CristeaDP/Voltage-stabilizer-with-series-regulator/Layout/layout.jpg

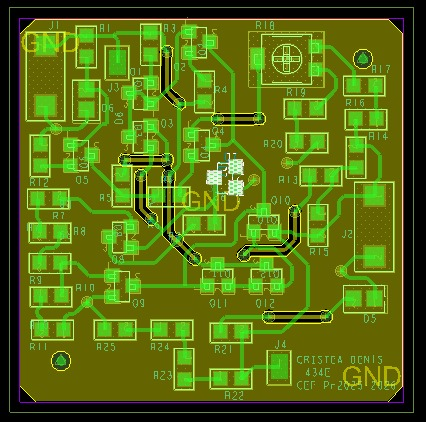
Layout/layout.jpg
