CristeaDP/Voltage-stabilizer-with-series-regulator/README.md

```
STABILIZATOR DE TENSIUNE CU ELEMENT DE REGLAJ SERIE (3–6 V)

DESCRIERE
Acest proiect prezintă proiectarea și analiza unui stabilizator de tensiune
liniar cu element de reglaj serie (ERS), capabil să furnizeze o tensiune
stabilizată reglabilă în intervalul 3 V – 6 V.

Scopul stabilizatorului este de a menține o tensiune de ieșire constantă
chiar și atunci când:
- tensiunea de intrare variază
- sarcina conectată la ieșire se modifică

Reglarea tensiunii se realizează prin intermediul unui tranzistor utilizat
ca element de reglaj serie, care controlează căderea de tensiune dintre
intrare și ieșire.

PRINCIPIUL DE FUNCȚIONARE
Stabilizatorul funcționează pe baza controlului curentului care trece
de la sursa de alimentare către sarcină.

Blocurile principale ale circuitului sunt:

1. Sursa de tensiune de intrare
   Furnizează tensiunea brută ce trebuie stabilizată.

2. Referința de tensiune
   Generează o tensiune stabilă utilizată pentru reglaj.

3. Amplificatorul de eroare
   Compară tensiunea de ieșire cu tensiunea de referință.

4. Elementul de reglaj serie (tranzistor)
   Controlează căderea de tensiune pentru menținerea
   unei tensiuni constante la ieșire.

5. Sarcina
   Circuitul alimentat de stabilizator.

CARACTERISTICI PRINCIPALE
- Tip stabilizator: liniar cu element de reglaj serie
- Tensiune de ieșire reglabilă: 3 V – 6 V
- Stabilizare la variații ale tensiunii de intrare
- Stabilizare la variații ale sarcinii
- Proiect verificat prin simulări

STRUCTURA PROIECTULUI

Bill_of_Materials
Lista componentelor utilizate în circuit

Data_Sheets
Fișele tehnice ale componentelor electronice

Layout
Fișierele pentru layout-ul plăcii PCB

Project docs
Documentația proiectului

Schematics / FAZA_1
Schema electrică a stabilizatorului

Simulations
Fișierele și rezultatele simulărilor circuitului

FIȘIERE SUPLIMENTARE
Schema_bloc.jpg
Diagrama bloc a sistemului

PCB_Manufacturing_Table.docx
Parametrii necesari pentru fabricarea PCB-ului

Prezentarea_Cristea_Denis_434E.pptx
Prezentarea proiectului

Tema 3 - Stabilizator de tensiune cu ERS.pdf
Cerințele și descrierea temei

APLICAȚII
Stabilizatoarele de tensiune de acest tip sunt utilizate în:
- alimentarea circuitelor electronice de mică putere
- sisteme embedded
- circuite analogice sensibile la variații de tensiune
- aplicații educaționale în electronică

AUTOR
Denis Cristea
Proiect realizat în cadrul laboratorului de Electronică.
```
