CristeaDP/Voltage-stabilizer-with-series-regulator/Schematics/FAZA_1/Lib_ModelePSpice_Anexa_1/Lib_ModelePSpice_Anexa_1/A1-active lib.docx

77 | 4148 | (LINK) (http://www.tme.eu/ro/details/1n4148-0805/diode-universale-smd/dc-components/cd4148ws0805c/) | 1N4148-0805
79 | 2.7V | (LINK) (http://www.tme.eu/ro/details/bzx84c2v7/diode-zener-smd/on-semiconductor/bzx84c2v7lt1g/) | BZX84C2V7
80 | 5.1V | (LINK) (http://www.tme.eu/ro/details/bzx84c5v1/diode-zener-smd/nxp/bzx84-c5v1215/) | BZX84C5V1
81 | 5.6V | (LINK) (http://www.tme.eu/ro/details/bzx84c5v6/diode-zener-smd/nxp/bzx84-c5v6215/) | BZX84C5V6
82 | 6.2V | (LINK) (http://www.tme.eu/ro/details/bzx84c6v2/diode-zener-smd/nxp/bzx84-c6v2215/) | BZX84C6V2
83 | 6.8V | (LINK) (http://www.tme.eu/ro/details/bzx84c6v8/diode-zener-smd/nxp/bzx84-c6v8215/) | BZX84C6V8
84 | 8.2V | (LINK) (http://www.tme.eu/ro/details/bzx84c8v2/diode-zener-smd/nxp/bzx84-c8v2215/) | BZX84C8V2
85 | 10V | (LINK) (http://www.tme.eu/ro/details/bzx84c10/diode-zener-smd/nxp/bzx84-c10215/) | BZX84C10
86 | PNP | (LINK) (http://www.tme.eu/ro/details/bc856b.215/tranzistori-smd-pnp/nxp/) | BC856B
87 | NPN | (LINK) (http://www.tme.eu/ro/details/bc846b.215/tranzistori-smd-npn/nxp/) | BC846B
89 | N-JFET | (LINK) (http://www.tme.eu/ro/details/mmbfj309lt1g/tranzistori-canal-n-smd/on-semiconductor/) | MMBFJ309LT1G
90 | P-JFET | (LINK) (http://www.tme.eu/ro/details/mmbfj177lt1g/tranzistori-canal-p-smd/on-semiconductor/) | MMBFJ177LT1G
91 | NPN | (LINK) (http://www.tme.eu/ro/details/bc817-25-dio/tranzistori-smd-npn/diotec-semiconductor/bc817-25/) | BC817-25-DIO
93 | PNP | (LINK) (http://www.tme.eu/ro/details/bc807-25-dio/tranzistori-smd-pnp/diotec-semiconductor/bc807-25/) | BC807-25-DIO
94 | NPN | (LINK) (http://www.tme.eu/ro/details/mjd31cg/tranzistori-smd-npn/on-semiconductor/) | MJD31CG
96 | PNP | (LINK) (http://www.tme.eu/ro/details/mjd32cg/tranzistori-smd-pnp/on-semiconductor/) | MJD32CG
97 | Nmos | (LINK) (http://www.tme.eu/ro/details/irfr120npbf/tranzistori-canal-n-smd/international-rectifier/) | IRFR120NPBF
