CristeaDP/Voltage-stabilizer-with-series-regulator/Proiect docs/Proiect_1_Cristea_Denis.pdf

Universitatea Națională de Știință și Tehnologie POLITEHNICA București Facultatea de Electronică, Telecomunicații și Tehnologia Informației

# Circuite Electronice Fundamentale 2 – Proiect

Stabilizator de tensiune cu element de reglaj serie (ERS)

Student: CRISTEA Denis-Petrișor | Profesori coordonatori: Dr.Ing Florin Draghici
Grupă: 434E | S.I.dr.Ing Mihaela Pantazica

An universitar 2025-2026

# Cuprins

### 1. Date inițiale de proiectare

### 2. Conținut tehnic/științific al proiectului

### 3. Simulări efectuate pentru a demonstra funcționalitatea în

parametrii impuși

### 1. Date inițiale de proiectare

### 1.1. Tema proiectului

Să se proiecteze și realizeze un stabilizator de tensiune cu ERS având următoarele caracteristici pentru N = 6:

- Tensiunea de ieșire reglabilă în intervalul: 3 – 6 [V];
- Element de reglaj serie;
- Sarcină la ieșire: 240 [Ω];
- Deriva termică: < 2mV/°C;
- Protecție la suprasarcină prin limitarea temperaturii tranzistorului regulator serie la 120 °C și a curentului maxim la 0,5A;
- Tensiune de intrare în intervalul: 10.8 – 12 [V]
- Domeniul temperaturilor de funcționare: 0 ° -60 °C (verificabil prin testare în temperatură);
- Amplificarea în tensiune minimă (în buclă deschisă) a amplificatorului de eroare: minim 100;
- Semnalizarea prezenței tensiunilor de intrare/ieșire cu diodă de tip LED.

### 1.2. Schema bloc a montajului electric

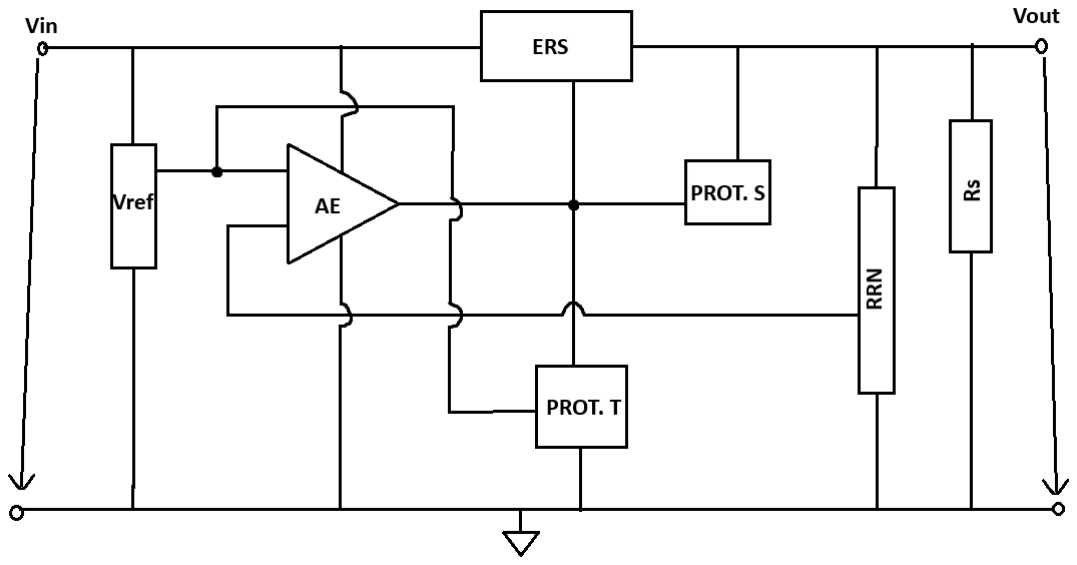
[picture p9: figure]

LEGENDA:
- V REF - referința de tensiune
- AE - amplificator operațional de eroare
- ERS - element de reglaj serie ( grupare Darlington)
- PROTECȚIE S. - circuit de protecție la suprasarcină
- PROTECȚIE T. - circuit de protecție la temperature
- RRN - rețea de reacție negative
- RS - sarcina la ieșire

### 1.3. Schema electrică a montajului electric

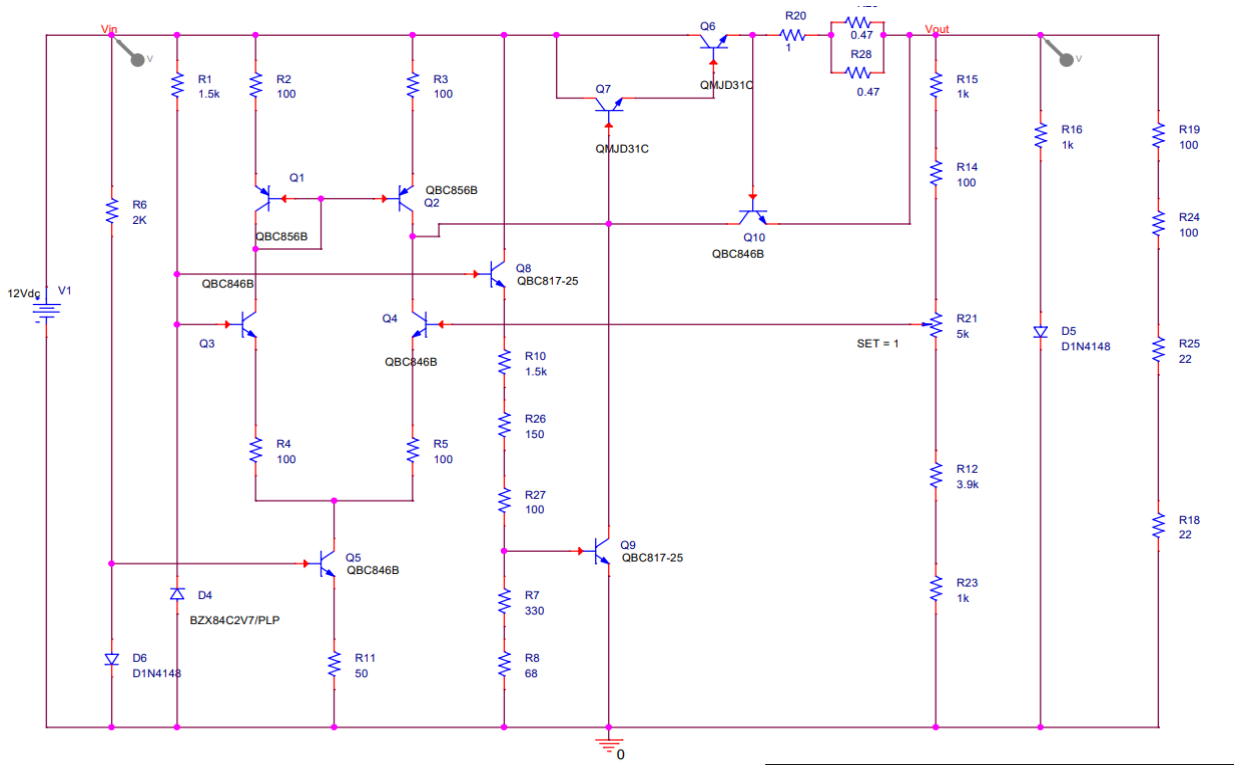
[picture p10: figure]

Compunerea circuitului din următoarele blocuri:
- Referința de tensiune : DZ
- Amplificator operațional de eroare: tranzistoarele Q3, Q4, oglinda de curent Q1, Q2, R2, R3 și generatorul de curent Q5, R11
- Element de reglaj serie (ERS): Q6, Q7 ( în configurație Darlington )
- Protecția la suprasarcină: Q10, R20
- Protecția termică: Q8, Q9, R10, R26, R27, R7, R8
- Rețeaua de reacție negativă: R15, R14, R12, R21, R23
- Impedanța de sarcină: R19, R24, R25, R18
- Semnalizare LED-uri: Intrare: D6, R6 ; Ieșire: D5, R16

### 2. Conținut tehnic/științific al proiectului

### 2.1. Descrierea funcționării schemei de proiectare

Stabilizatorul de tensiune este circuitul cu rol în asigurarea la ieșire a unei tensiuni constante în condițiile în care tensiunea de la intrare, curentul și temperatura variază.

### 2.1.1. Referința de tensiune

Această parte a circuitului utilizează o diodă Zener pentru a stabiliza tensiunea de intrare, fără a ține cont de diverși parametrii precum: sarcina, variațiile tensiunii de alimentare sau chiar ale temperaturii.
Circuitul implică utilizarea unei diode de tip BZX84-C2V7, care are o tensiune de străpungere constantă de aproximativ 2.7V la un curent de 6mA. Dioda Zener va funcționa în regim de străpungere, iar un aspect important este asigurarea unui curent prin aceasta mai mare decât Izmin (curentul minim necesar pentru a menține dioda în regim de străpungere).

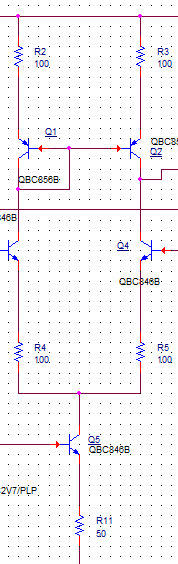
[picture p11: figure]

### 2.1.2. Amplificatorul de eroare

În acest circuit de amplificare a erorii, tensiunea de ieșire eșantionată este adusă înapoi și comparată cu o tensiune de referință stabilă. Orice diferență între cele două generează o tensiune de eroare de compensare, care acționează pentru a ajusta tensiunea de ieșire pentru a se conforma specificațiilor de proiectare.
Oglinda de curent formată din tranzistoarele Q1, Q2 și rezistențele R2 și R3 are rolul de a oferi o amplificare mult mai bună.

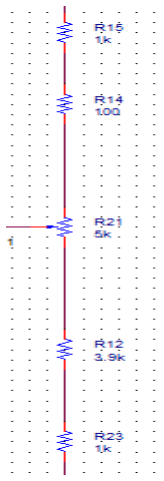
[picture p12: figure]

### 2.1.3. Rețeaua de reacție negativă - RRN

Rețeaua de reacție negativă are rolul de a regla, dar și de a menține tensiunea de ieșire. Aceasta primește o parte din tensiunea de ieșire, pe care o readuce în amplificator prin intrarea inversoare a acestuia.
R21 este un potențiometru (POT) de valoare 5k ce are rolul de a regla tensiunea de la ieșire între 3V și 6V.

### 2.1.4. Elementul de reglaj serie – ERS

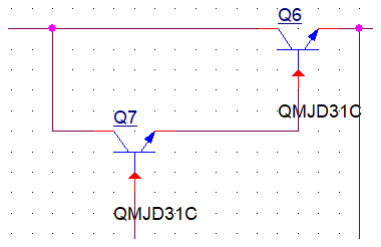
[picture p13: figure]

Elementul de reglaj serie este format din două tranzistoare de putere(de tip MJD31C), aflate într-o configurație de punte Darlington, tranzistoare ce furnizează curent cu un anumit câștig către ieșire.

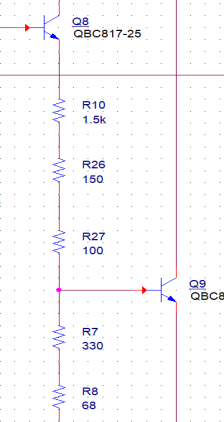
[picture p14: figure]

### 2.1.5. Protecția termică & Protecția la suprasarcină

Protecția termică este alcătuită din două tranzistoare, alături de un divizor rezistiv. Această protecție are rolul de a limita temperatura la 120 °C (temperatură specificată în cerință).

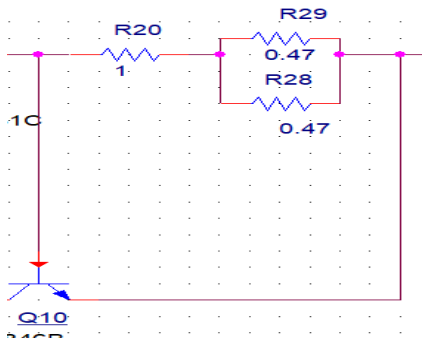
[picture p15: figure]

Protecția la suprasarcină este alcătuită dintr-un tranzistor și o rezistență. Atunci când curentul de pe gruparea de rezistențe ajunge la 0.5A, adică valoarea maximă pe care trebuie să o aibă curentul, tranzistorul nostru se va polariza și va începe să tragă curent din baza tranzistorului de la elementul de reglaj serie.

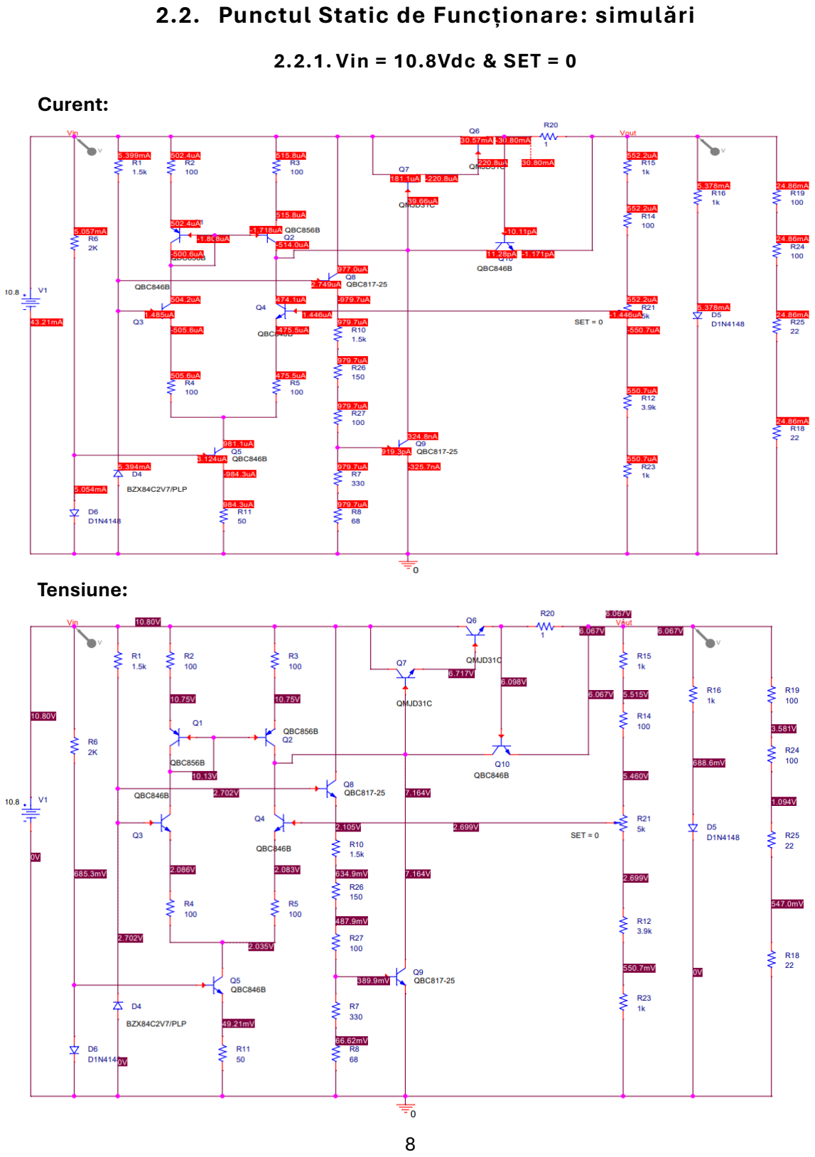
[picture p16: page 8]

### 2.2. Punctul Static de Funcționare: simulări

### 2.2.1. Vin = 10.8Vdc & SET = 0

Curent:

Tensiune:

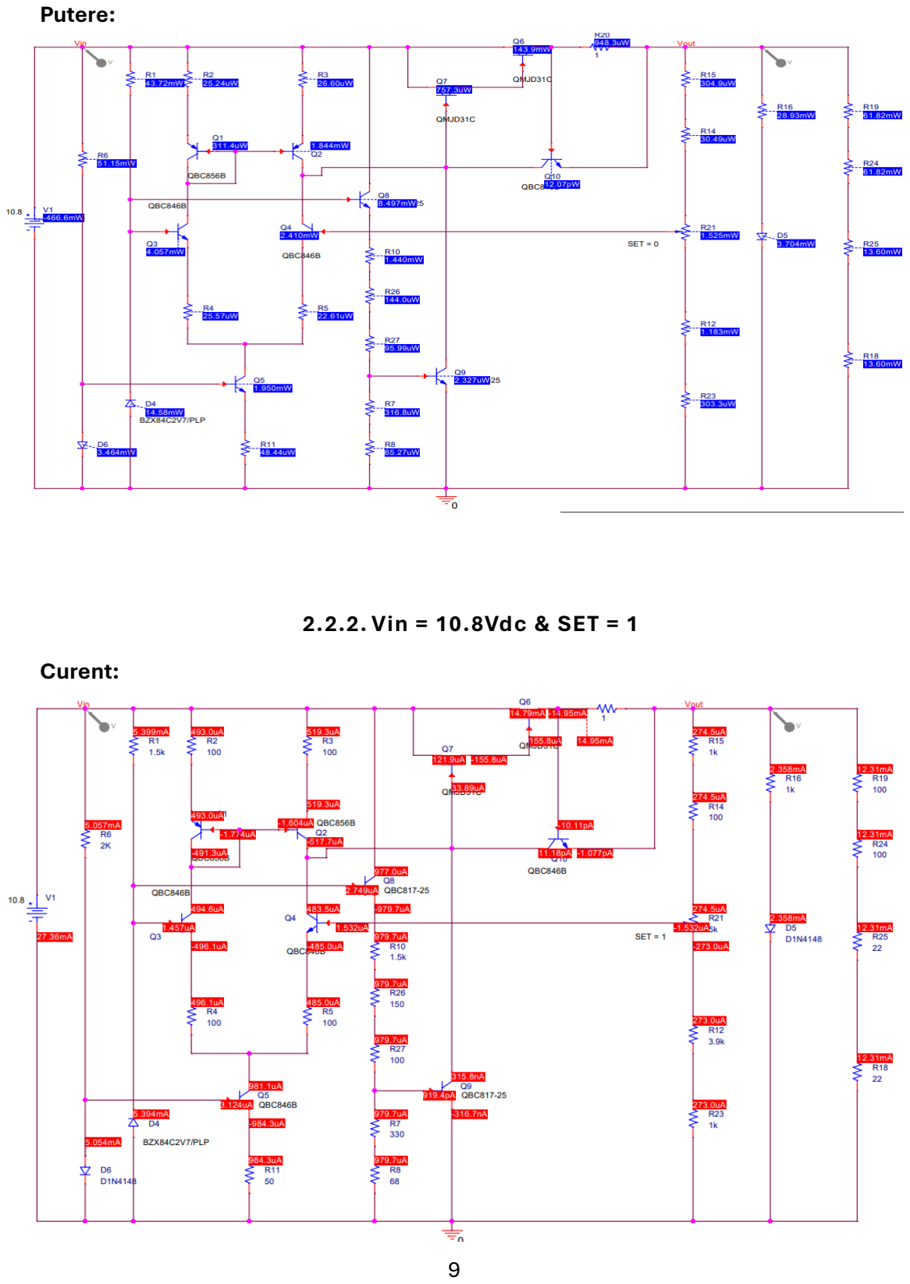
[picture p17: page 9]

Putere:

### 2.2.2. Vin = 10.8Vdc & SET = 1

Curent:

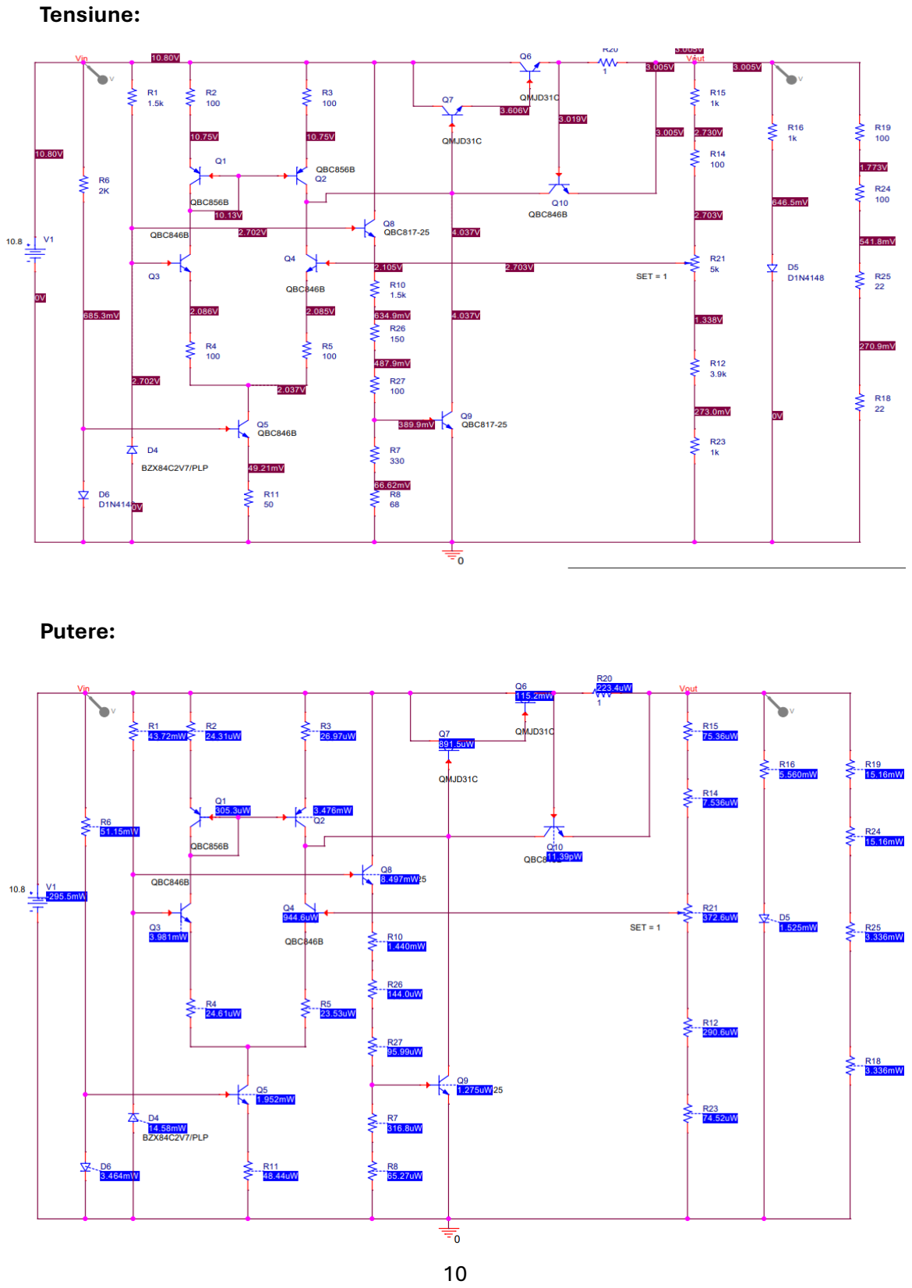
[picture p18: page 10]

Tensiune:

Putere:

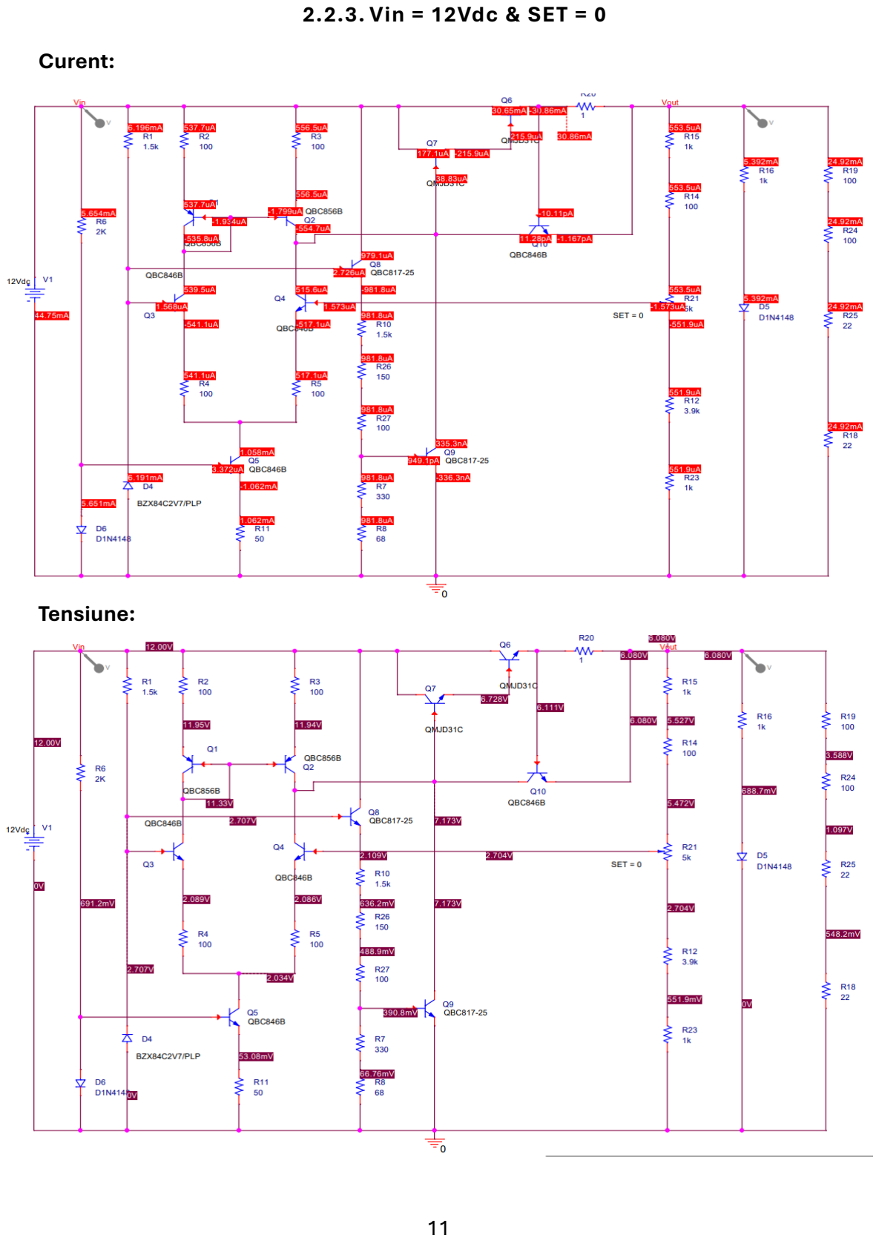
[picture p19: page 11]

### 2.2.3. Vin = 12Vdc & SET = 0

Curent:

Tensiune:

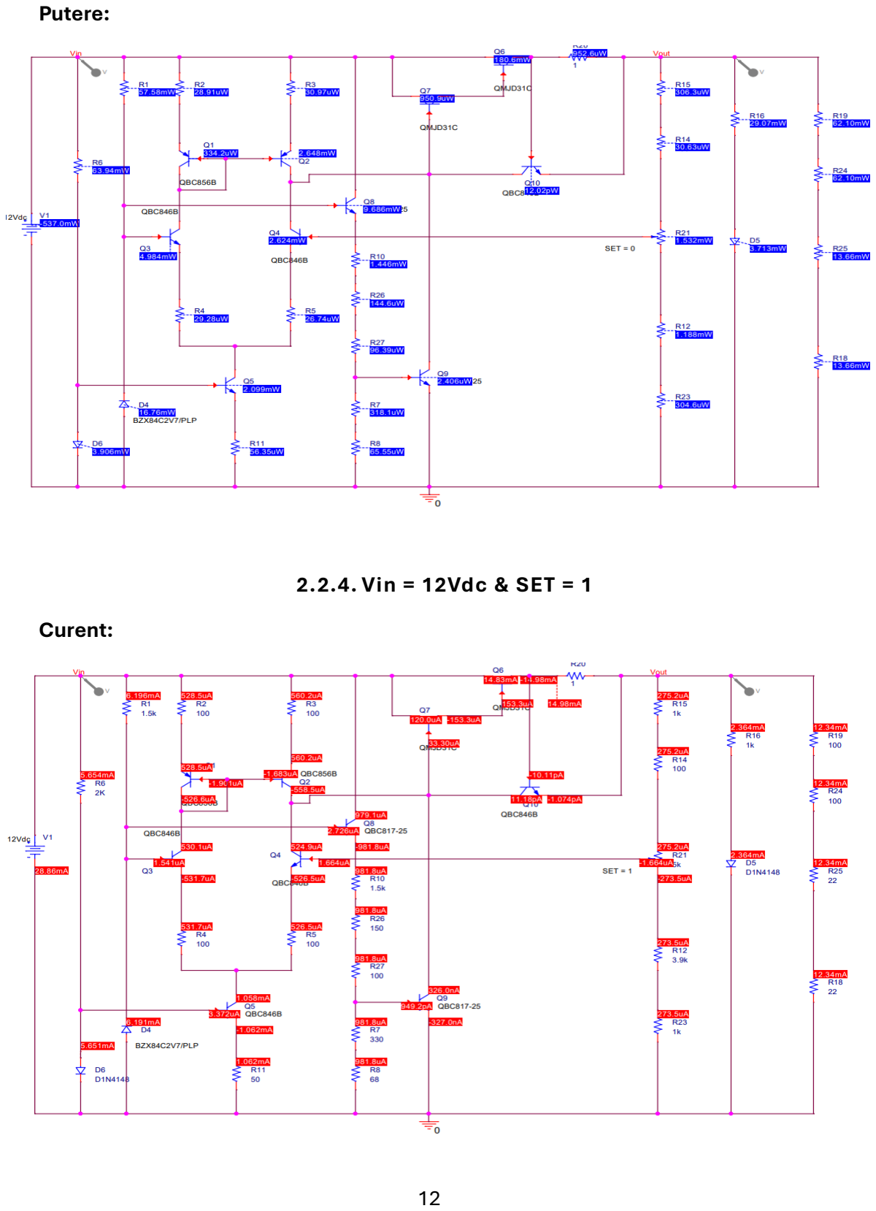
[picture p20: page 12]

Putere:

### 2.2.4. Vin = 12Vdc & SET = 1

Curent:

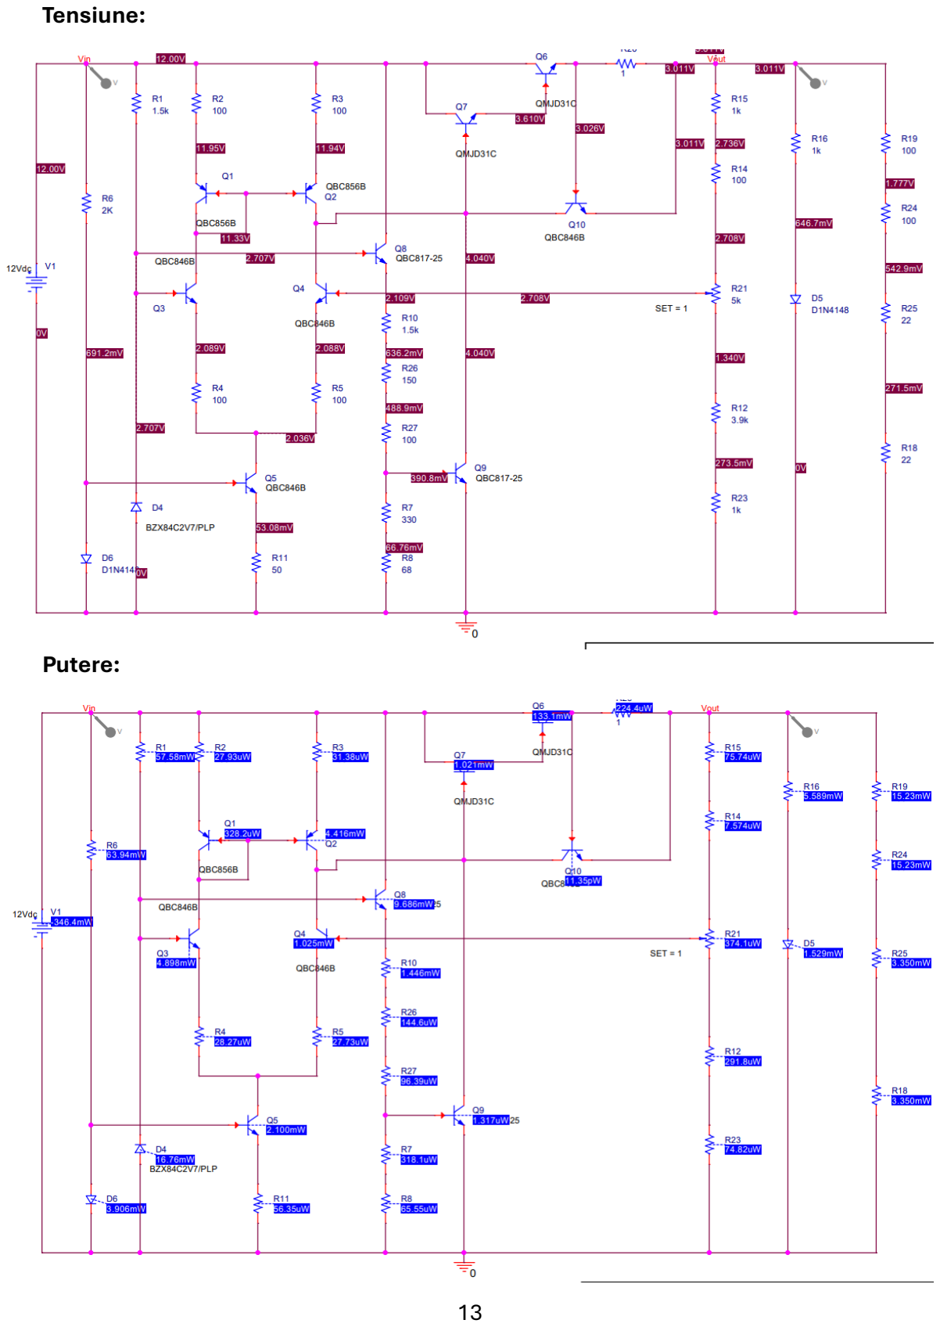
[picture p21: page 13]

Tensiune:

Putere:

### 2.3. Punctul Static de Funcționare: calcul analitic

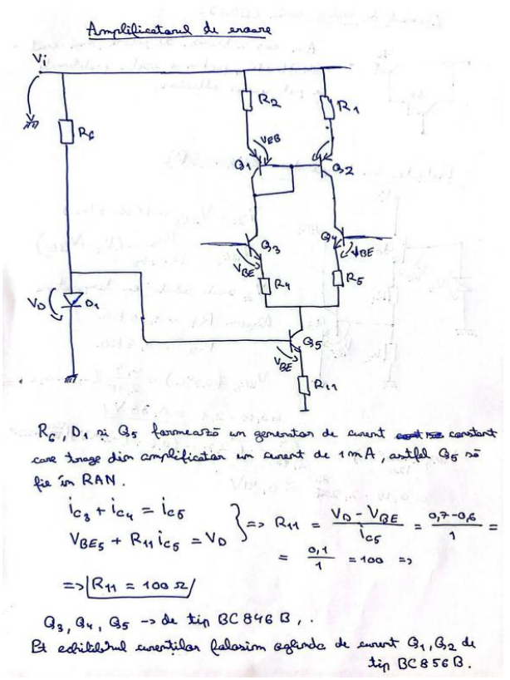
[picture p22: figure]

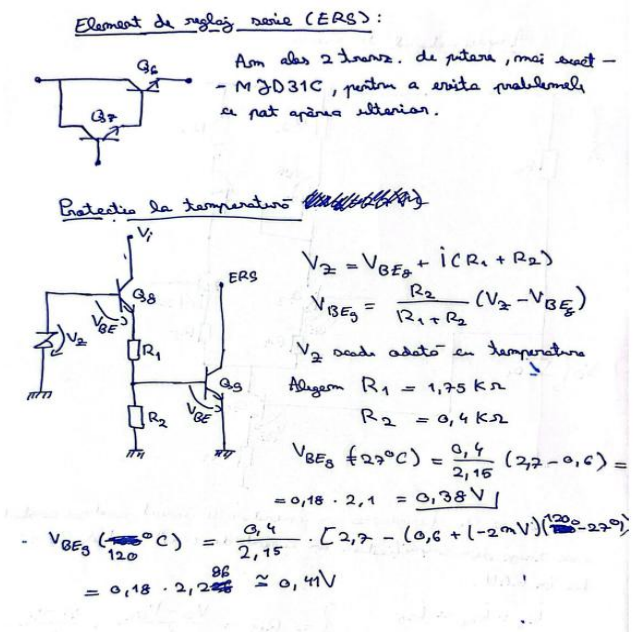
[picture p23: figure]

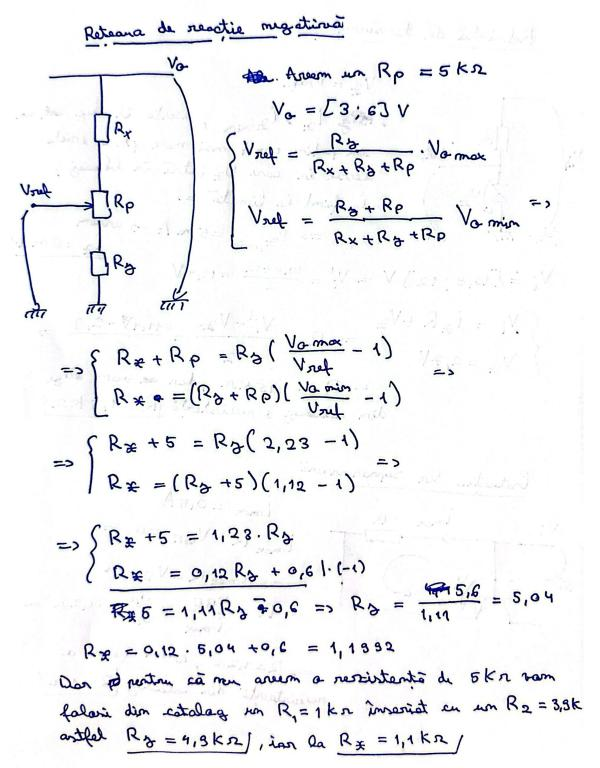
[picture p24: figure]

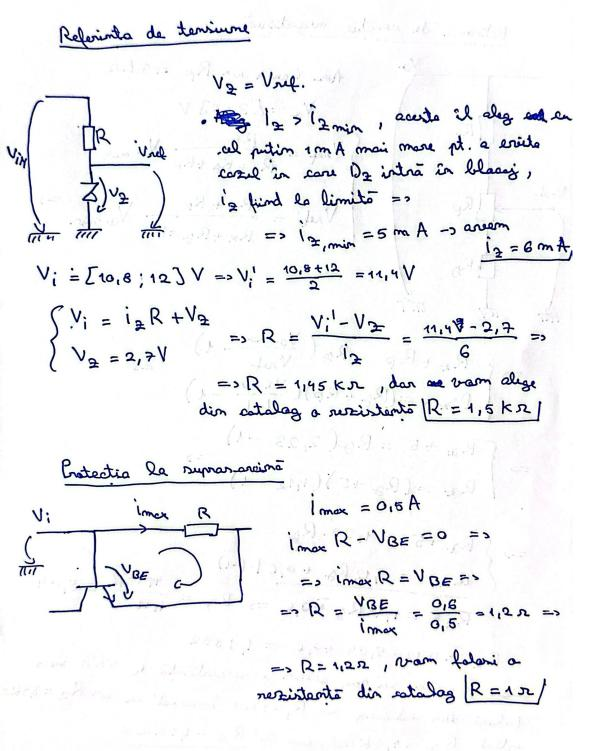
[picture p25: figure]

### 3. Simulări efectuate pentru a demonstra funcționalitatea în

parametrii impuși

### 3.1. Simulare Derivă termică

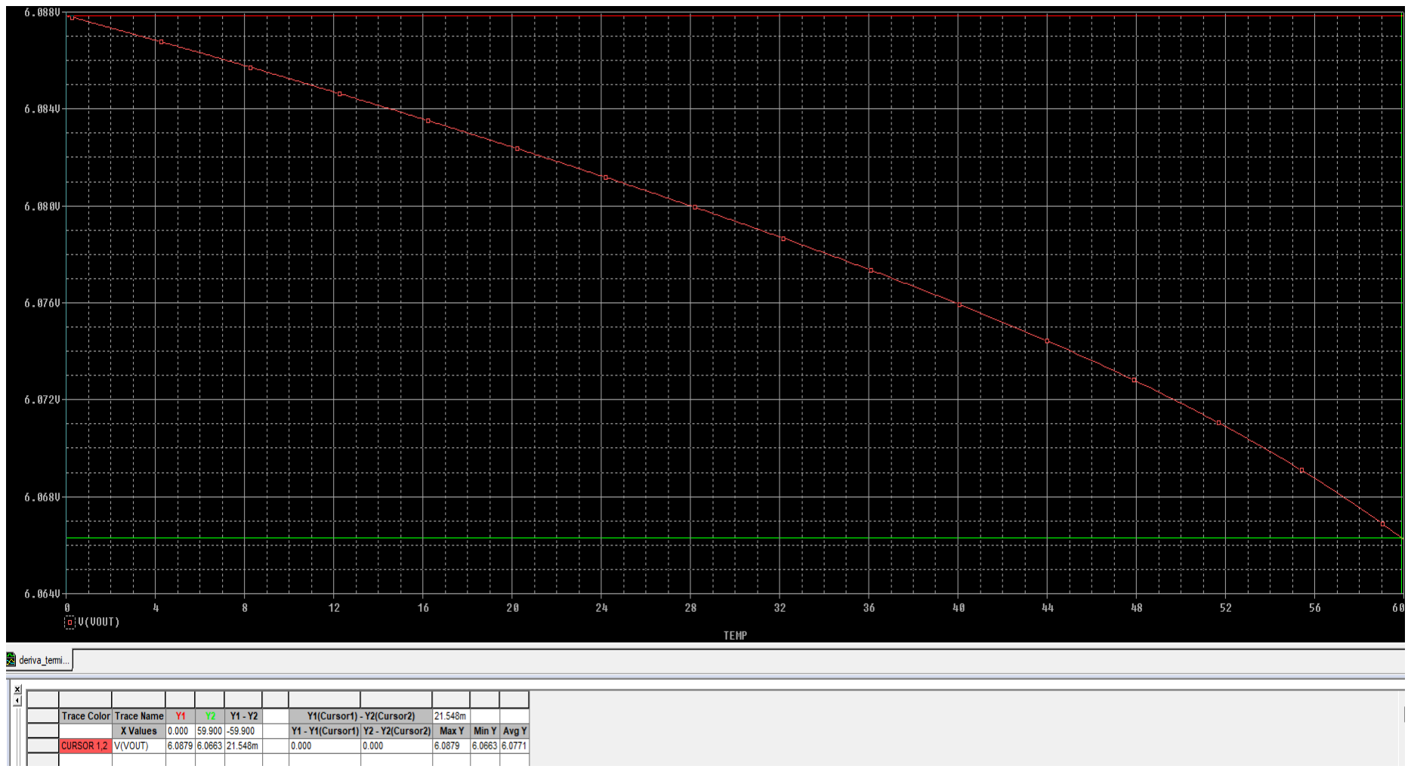
[picture p26: figure]

Deriva termică trebuie să fie < 2mV/°C.

Pentru calcule:
Y1 – Y2 = 21.548mV
t = 60° – 0° = 60°C

Deriva termică =

Y1−Y2
t

=

21.548mV
60°

≅ 0.359mV/°C < 2mV/°C

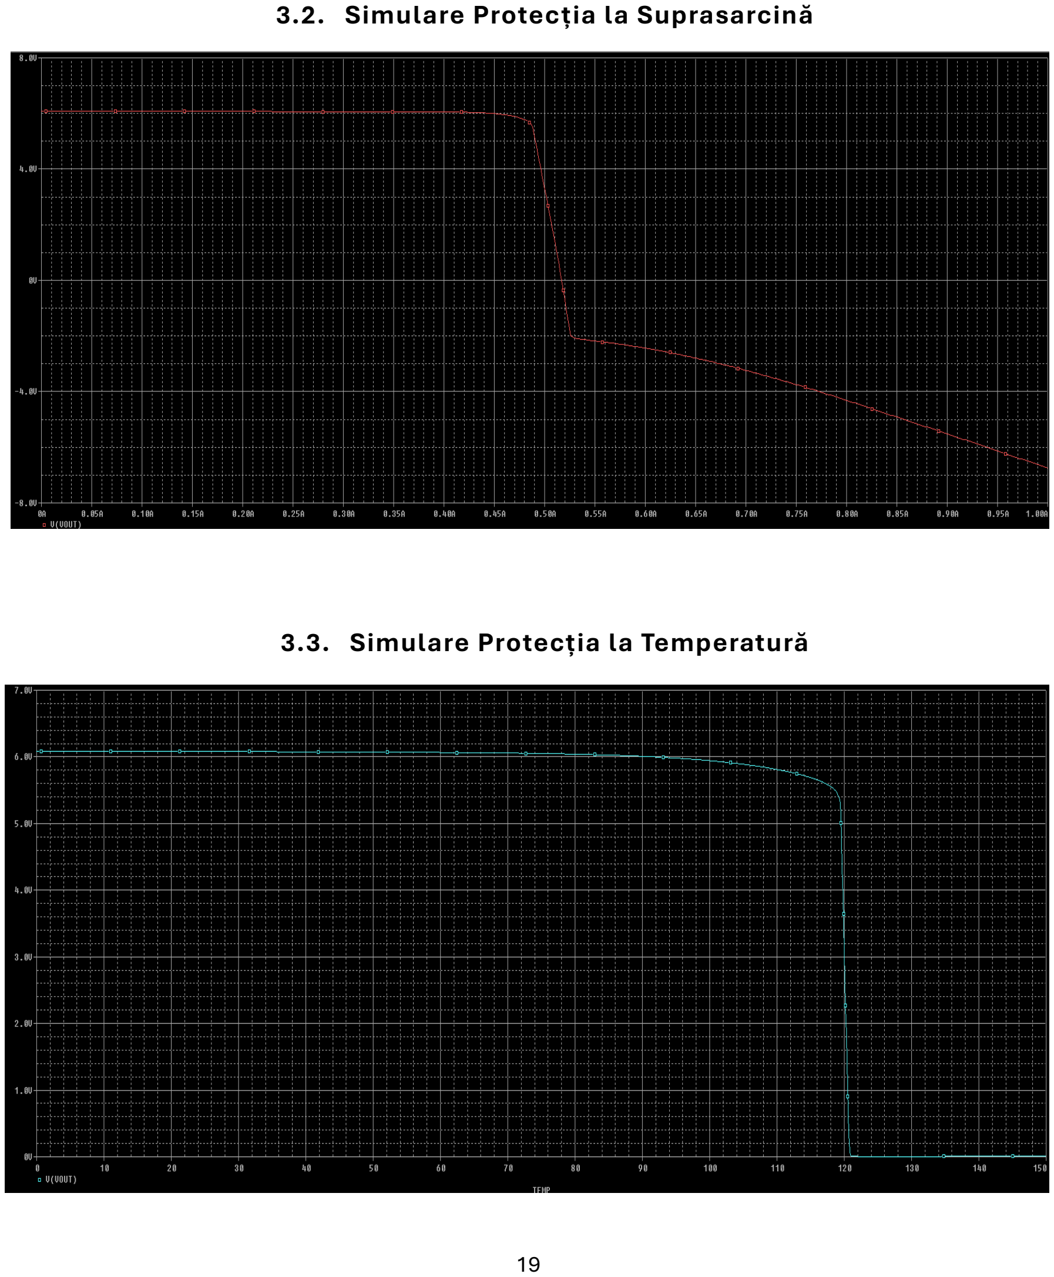
[picture p27: page 19]

### 3.2. Simulare Protecția la Suprasarcină

### 3.3. Simulare Protecția la Temperatură

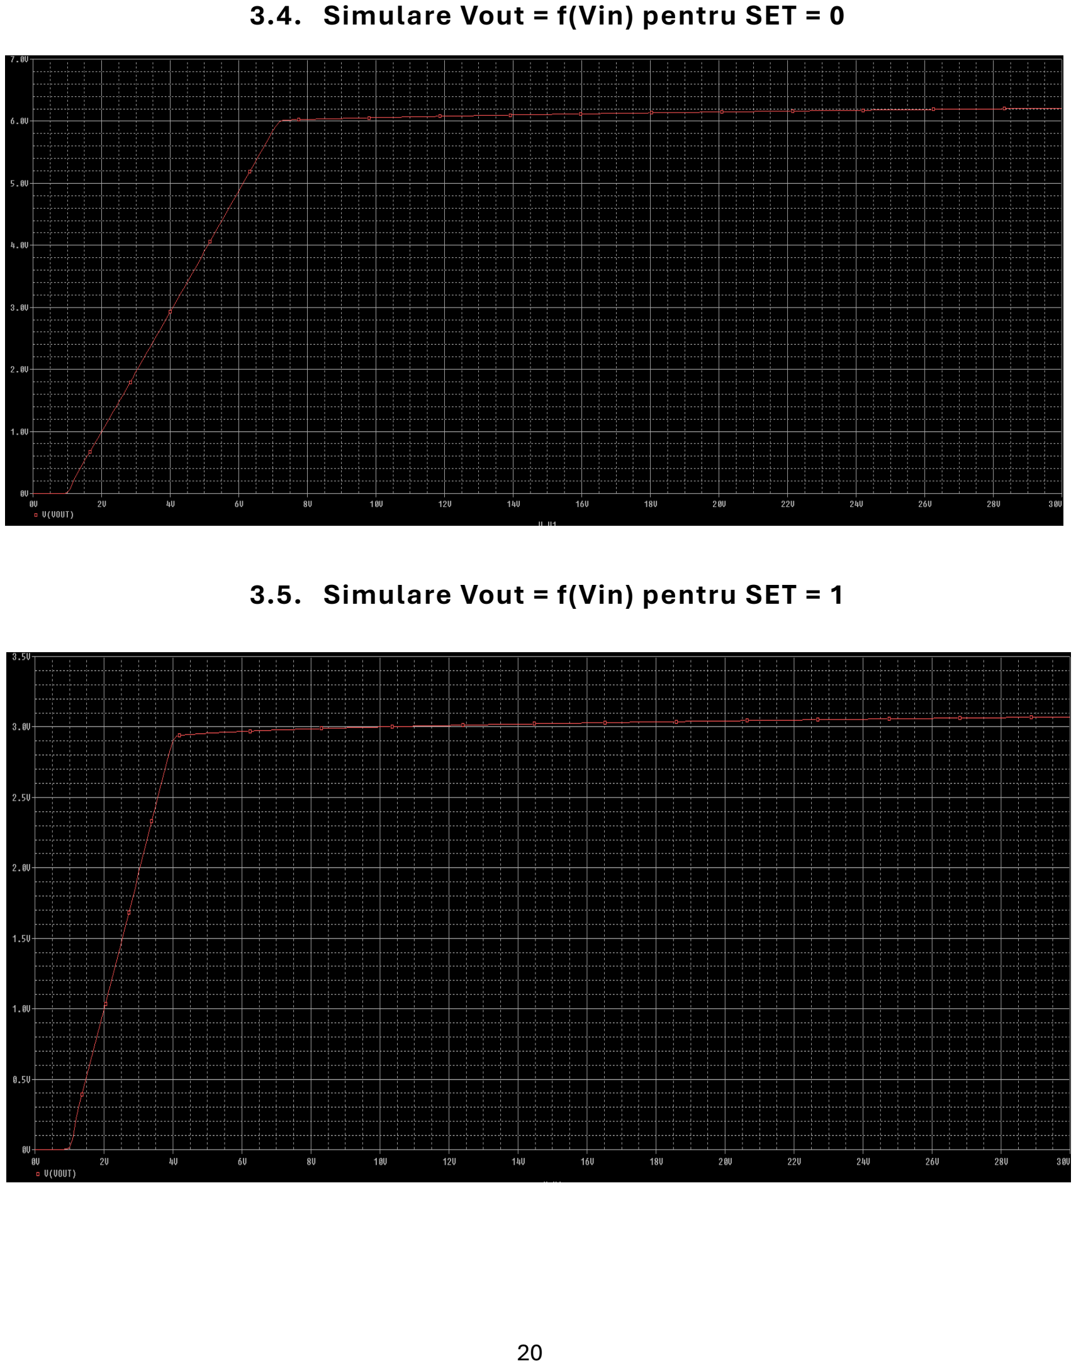
[picture p28: page 20]

### 3.4. Simulare Vout = f(Vin) pentru SET = 0

### 3.5. Simulare Vout = f(Vin) pentru SET = 1

### 3.6. Amplificarea in bucla deschisa

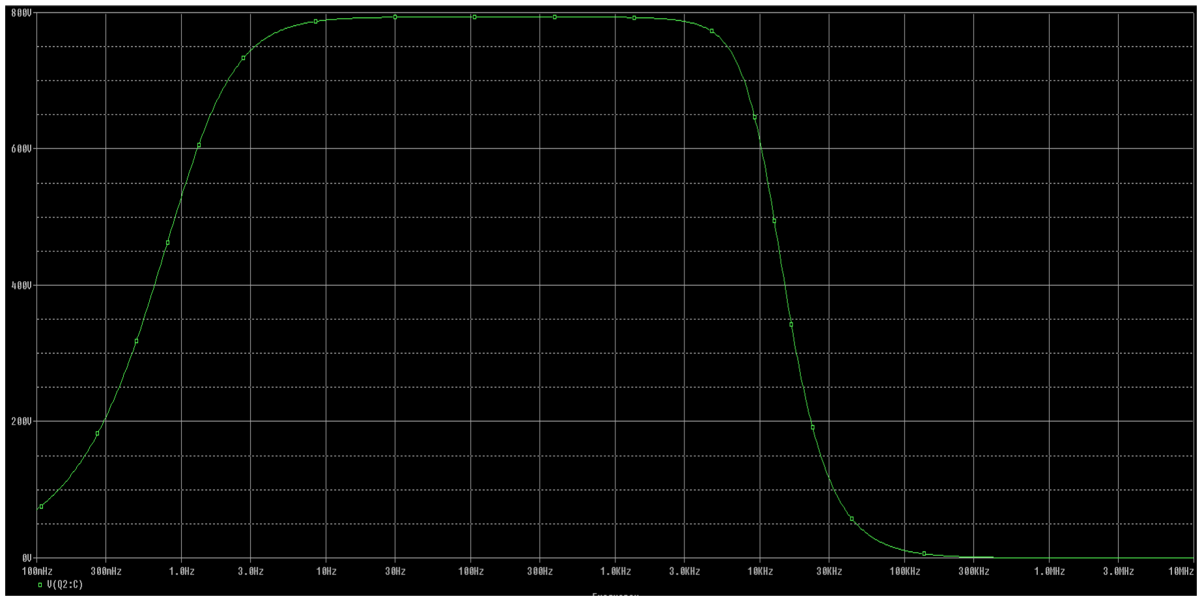
[picture p29: figure]

### 4. Bibliografie

1. Cursuri Tehnici CAD pentru Module Electronice
2. I. Ristea, C. A. Popescu – “Stabilizatoare de tensiune”, Editura tehnică
3. Cursuri Dispozitive Electronice
4. Cursuri Circuite Electronice Fundamentale
5. G. Brezeanu, F. Drăghici – “Circuite Electronice Fundamentale”, Editura Niculescu
6. Cursuri Circuite Integrate Analogice
7. https://www.tina.com/ro/resources/home/practical-operational-amplifiers/differential-amplifiers/ (https://www.tina.com/ro/resources/home/practical-operational-amplifiers/differential-amplifiers/)
