CristeaDP/Voltage-stabilizer-with-series-regulator/Simulations/Deriva_Termica.jpg

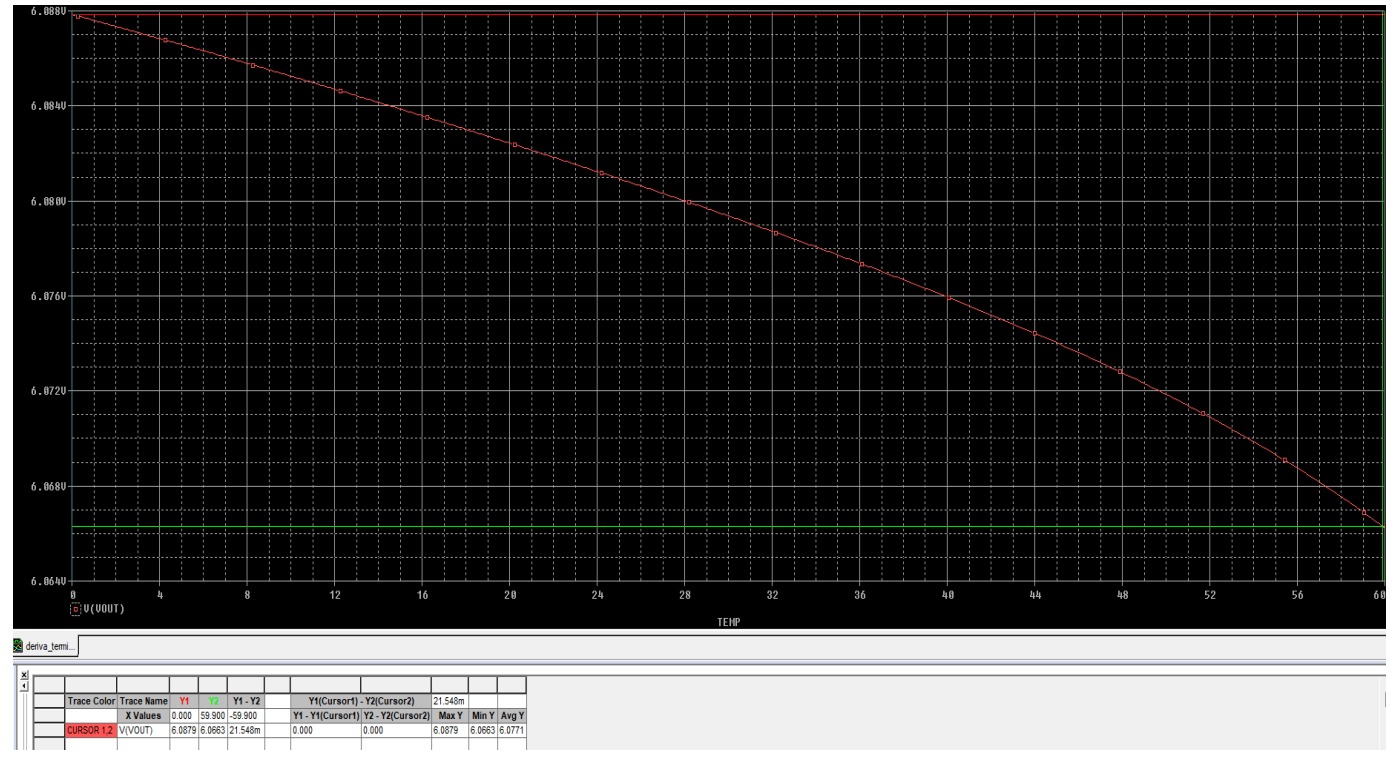
Simulations/Deriva_Termica.jpg
