CristeaDP/Voltage-stabilizer-with-series-regulator/Simulations/Protectia_la_supra_sarcina.jpg

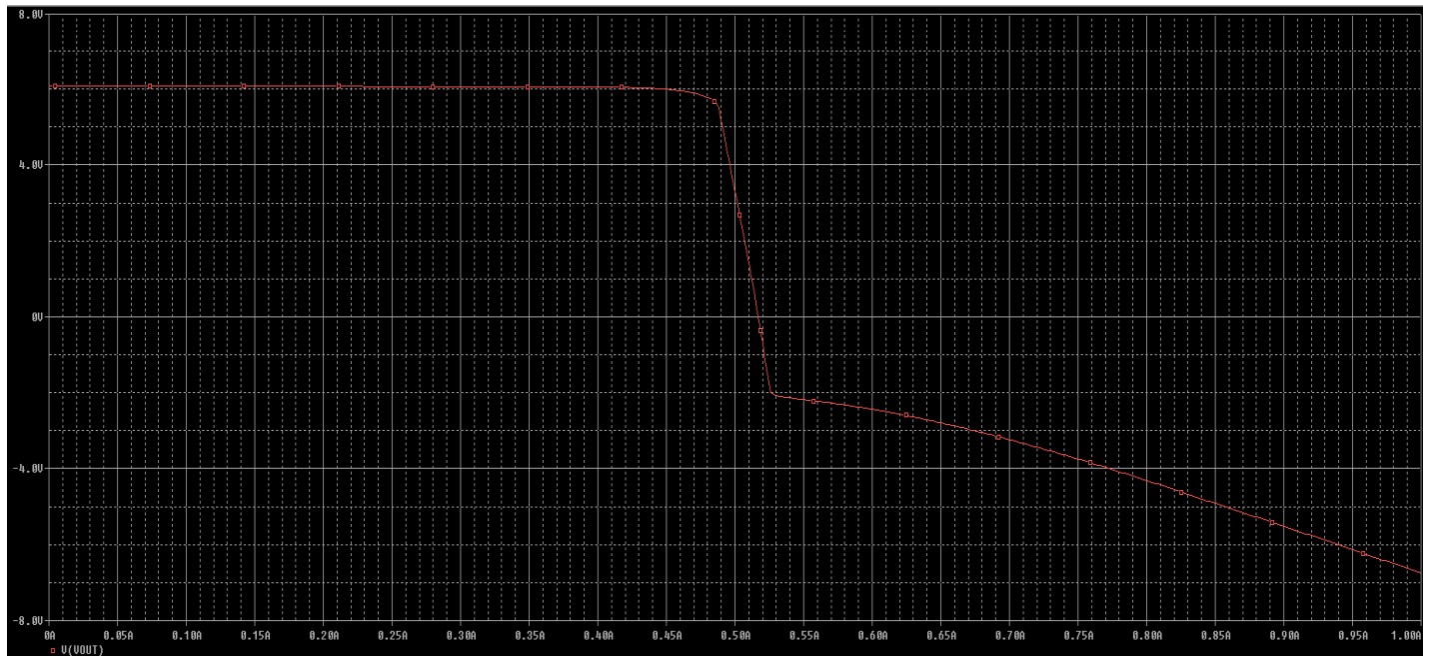
Simulations/Protectia_la_supra_sarcina.jpg
