CristeaDP/Voltage-stabilizer-with-series-regulator/Simulations/Protectia_Termica.jpg

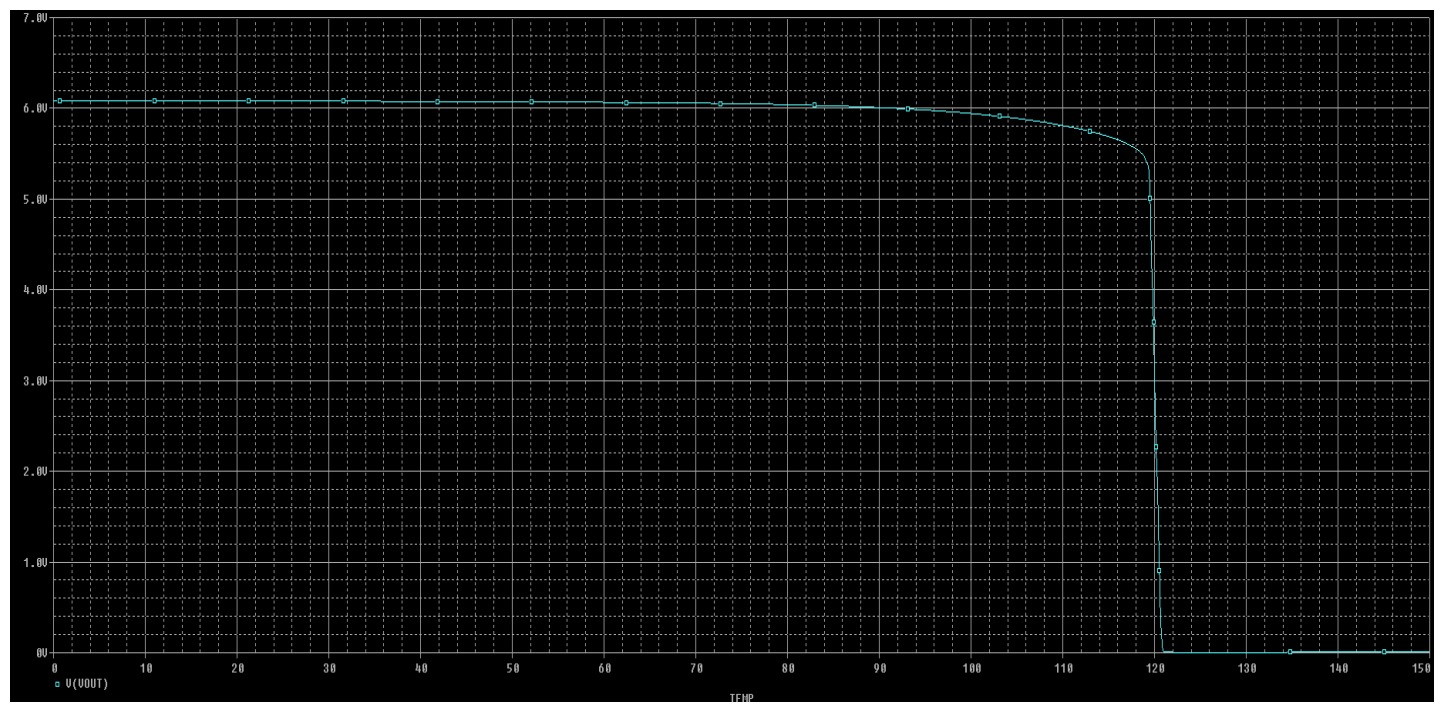
Simulations/Protectia_Termica.jpg
