CristeaDP/Voltage-stabilizer-with-series-regulator/Simulations/Stabilizarea_set_1.jpg

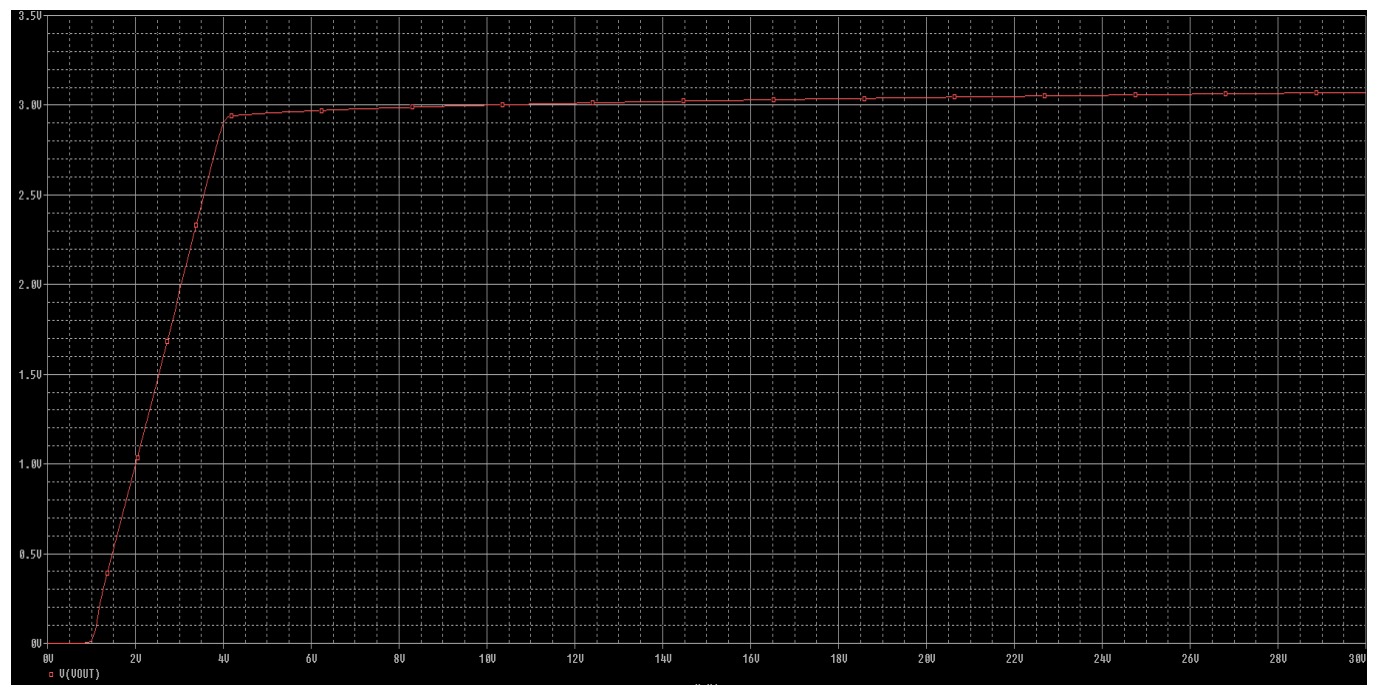
Simulations/Stabilizarea_set_1.jpg
