CristeaDP/Voltage-stabilizer-with-series-regulator/Schematics/FAZA_1/Proiect-CEF2-PSpiceFiles/SCHEMATIC1/Schematic1/Schematic1.cir

** Profile: "SCHEMATIC1-Schematic1"  [ c:\users\crist\desktop\test\proiect-cef2-PSpiceFiles\SCHEMATIC1\Schematic1.sim ] 

** Creating circuit file "Schematic1.cir" 
** WARNING: THIS AUTOMATICALLY GENERATED FILE MAY BE OVERWRITTEN BY SUBSEQUENT SIMULATIONS

*Libraries: 
* Profile Libraries :
* Local Libraries :
* From [PSPICE NETLIST] section of C:\Users\crist\AppData\Roaming\SPB_Data\cdssetup\OrCAD_PSpice\17.2.0\PSpice.ini file:
.lib "nomd.lib" 

*Analysis directives: 
.TRAN  0 1000ns 0 
.OPTIONS ADVCONV
.PROBE64 V(alias(*)) I(alias(*)) W(alias(*)) D(alias(*)) NOISE(alias(*)) 
.INC "..\SCHEMATIC1.net" 


.END
